scimusmn/nysci-combined-sewer/code/demo2/README.md

This folder contains three sketches, each used for the demonstration version of the Combined Sewer. `demo-controller` contains the code for the lighting controller; `demo-switches` contains the code for the user input controller; and `address-finder` is a helper sketch to blinnk the binary addresses fo each pixel.

The `camera-reader` python script is intended to make reading the addresses blinked by `address-finder` easier.
