scimusmn/nysci-combined-sewer/code/demo/address-query/README.md

# address-query

## usage

Upload the `address-query.ino` sketch to your Teensy and close all Arduino windows. Then, open this folder in `cmd.exe` and type

```
conda activate css-finder
python finder.py [YOUR_TEENSY_PORT_HERE]
```

## installation

tbd
