scimusmn/nysci-combined-sewer/electronics/LED Segment BOM.xlsx

Comment | Designator | Footprint | LCSC Part Number
Receivers 0/4 SOIC-16 RS-485 / RS-422 ICs ROHS | U2 | SMM:DS26C31TMX | C527395 (https://jlcpcb.com/partdetail/TexasInstruments-DS26C32ATMXNOPB/C527395)
2.2uF | C1 | Capacitor_SMD:C_0805_2012Metric
1uF | C2 | Capacitor_SMD:C_0805_2012Metric
120 Ohm Surface Mount Resistor | R1 | Resistor_SMD:R_1206_3216Metric | C880970 (https://jlcpcb.com/partdetail/Ever_OhmsTech-CR1206F120RP05Z/C880970)
120 Ohm Surface Mount Resistor | R2 | Resistor_SMD:R_1206_3216Metric | C880970 (https://jlcpcb.com/partdetail/Ever_OhmsTech-CR1206F120RP05Z/C880970)
SOIC8(S) RS-485 / RS-422 ICs ROHS | U1 | Package_SO:SOIC-8_3.9x4.9mm_P1.27mm | C130186 (https://jlcpcb.com/partdetail/Chipanalog-CAIF4850HS/C7422579)
100mA Fixed 5V~5V Positive 30V TO-252-2(DPAK) Linear Voltage Regulators (LDO) ROHS | U3 | Package_TO_SOT_SMD:TO-252-2 | C179571 (https://jlcpcb.com/partdetail/Onsemi-LP2950CDT_50RKG/C179571)
