scimusmn/nysci-combined-sewer/electronics/led_segment/production/led_segment-gerber/LED Segment BOM.xlsx

Comment | Designator | Footprint | LCSC Part Number
Receivers 0/4 SOIC-16 RS-485 / RS-422 ICs ROHS | U2 | SMM:DS26C31TMX | C527395 (https://jlcpcb.com/partdetail/TexasInstruments-DS26C32ATMXNOPB/C527395)
3.3uF | C1 | Capacitor_SMD:C_0805_2012Metric
1uF | C2 | Capacitor_SMD:C_0805_2012Metric
200uF | C3 | Capacitor_Tantalum_SMD:CP_EIA-7361-38_AVX-V
120 Ohm Surface Mount Resistor | R1 | Resistor_SMD:R_1206_3216Metric | C880970 (https://jlcpcb.com/partdetail/Ever_OhmsTech-CR1206F120RP05Z/C880970)
120 Ohm Surface Mount Resistor | R2 | Resistor_SMD:R_1206_3216Metric | C880970 (https://jlcpcb.com/partdetail/Ever_OhmsTech-CR1206F120RP05Z/C880970)
SOIC8(S) RS-485 / RS-422 ICs ROHS | U1 | Package_SO:SOIC-8_3.9x4.9mm_P1.27mm | C130186 (https://jlcpcb.com/partdetail/Chipanalog-CAIF4850HS/C7422579)
500mA Fixed 5V Positive electrode 35V TO-252-2L Voltage Regulators - Linear, Low Drop Out (LDO) Regulators ROHS | U3 | Package_TO_SOT_SMD:TO-252-2 | C9070
