scimusmn/nysci-combined-sewer/electronics/led_segment/led_segment.kicad_pcb

## KiCad design electronics/led_segment/led_segment.kicad_pcb (2024-12-06)

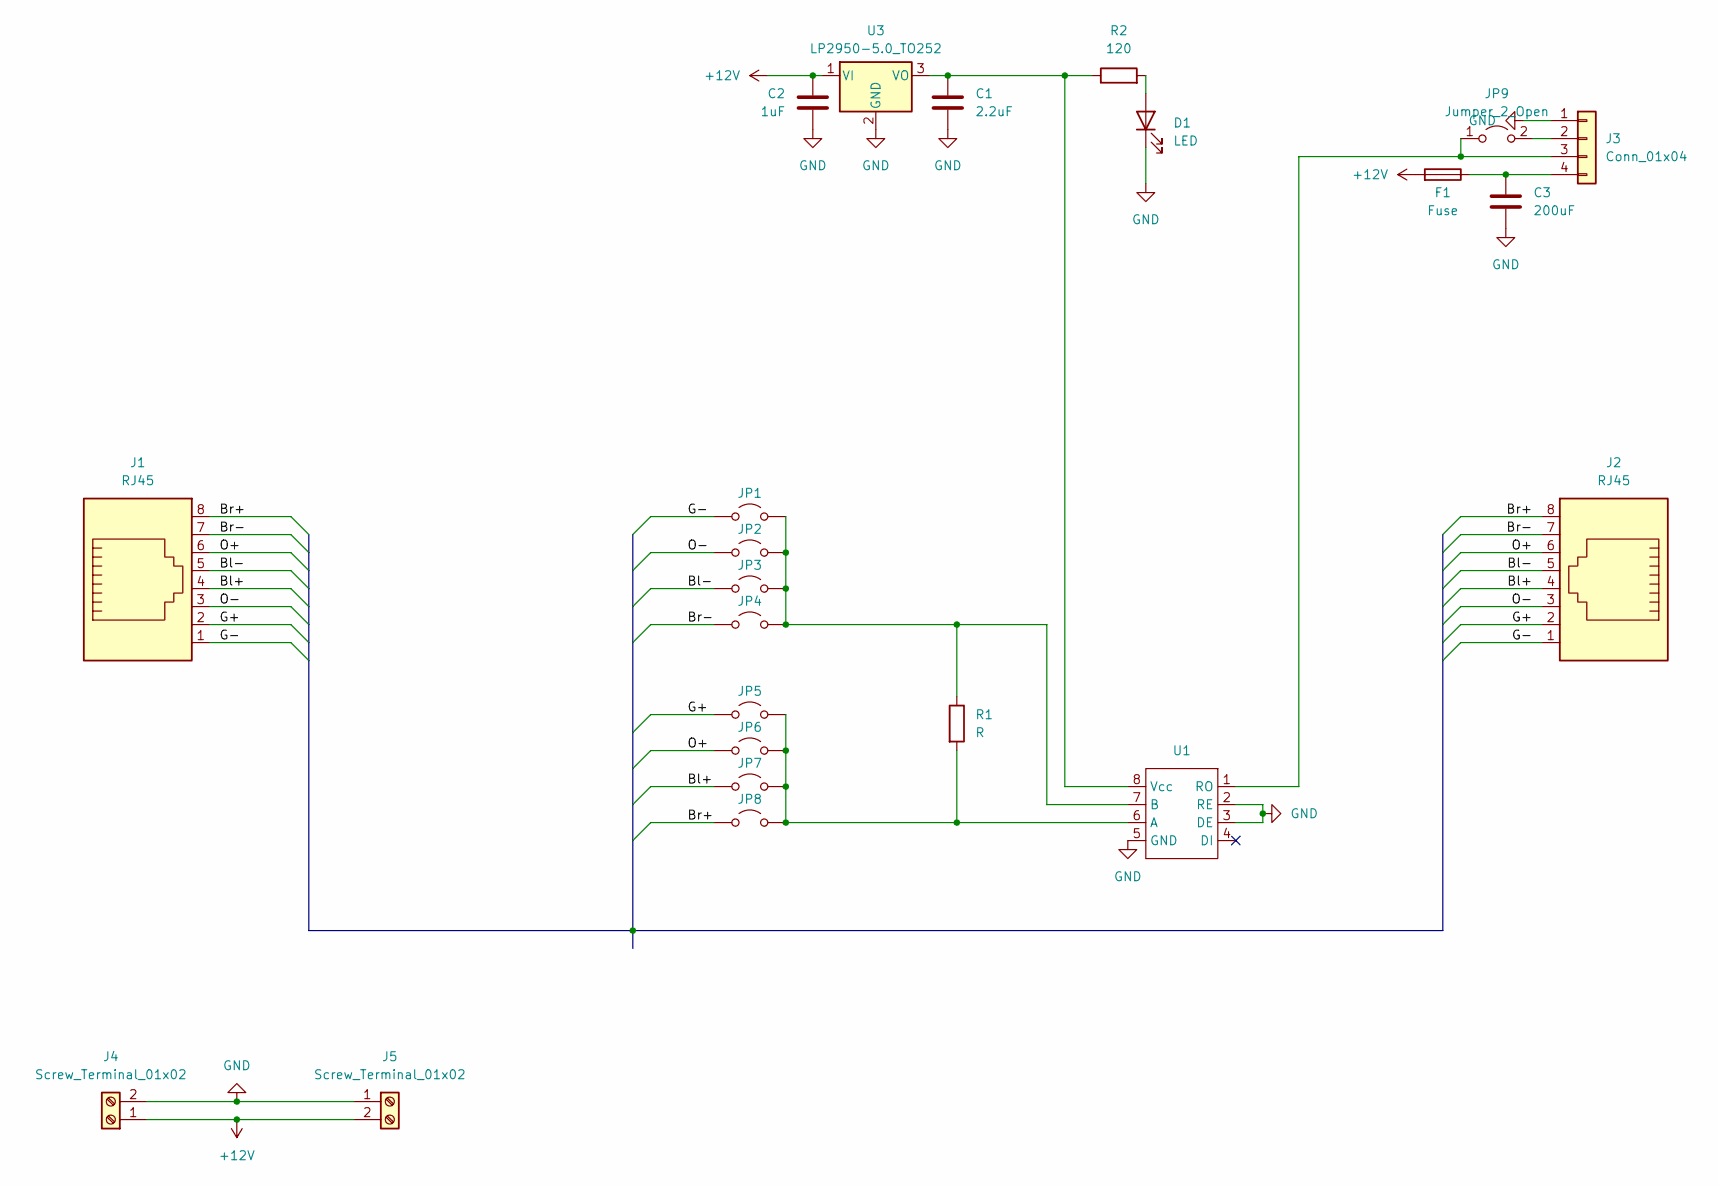
[picture p1: schematic led_segment.kicad_sch]

Parts:
C1: 2.2uF; C_0805_2012Metric; LCSC C377773
C2: 1uF; C_0805_2012Metric; LCSC C28323
C3: 200uF; CP_EIA-7361-38_AVX-V; LCSC TAJV227M016RNJ
D1: LED; LED_D3.0mm
F1: Fuse; 3549-2
J1, J2: RJ45; RJ45_Ninigi_GE; LCSC C708636
J3: Conn_01x04; KK-1x04_right
J4, J5: Screw_Terminal_01x02; P-2604-1102_1
JP1, JP2, JP3, JP4, JP5, JP6, JP7, JP8, JP9: Jumper_2_Open; SolderJumper-2_P1.3mm_Open_Pad1.0x1.5mm
R1: R; R_1206_3216Metric
R2: 120; R_1206_3216Metric
U1: SOIC-8_3.9x4.9mm_P1.27mm; LCSC C7422579
U3: LP2950-5.0_TO252; TO-252-2; LCSC C130186

Connections:
+12V: C2.1, F1.2, J4.1, J5.2, U3.1 (VI)
/Bl+: J1.4, J2.4, JP7.1 (A)
/Bl-: J1.5, J2.5, JP3.1 (A)
/Br+: J1.8, J2.8, JP8.1 (A)
/Br-: J1.7, J2.7, JP4.1 (A)
/G+: J1.2, J2.2, JP5.1 (A)
/G-: J1.1, J2.1, JP1.1 (A)
/O+: J1.6, J2.6, JP6.1 (A)
/O-: J1.3, J2.3, JP2.1 (A)
GND: C1.2, C2.2, C3.2, D1.1 (K), J3.1, J4.2, J5.1, U1.2 (RE), U1.3 (DE), U1.5 (GND), U3.2 (GND)
unnamed: D1.2 (A), R2.2
unnamed: J3.2, JP9.2 (B)
unnamed: J3.3, JP9.1 (A), U1.1 (RO)
unnamed: C3.1, F1.1, J3.4
unnamed: JP1.2 (B), JP2.2 (B), JP3.2 (B), JP4.2 (B), R1.1, U1.7 (B)
unnamed: JP5.2 (B), JP6.2 (B), JP7.2 (B), JP8.2 (B), R1.2, U1.6 (A)
unnamed: C1.1, R2.1, U1.8 (Vcc), U3.3 (VO)

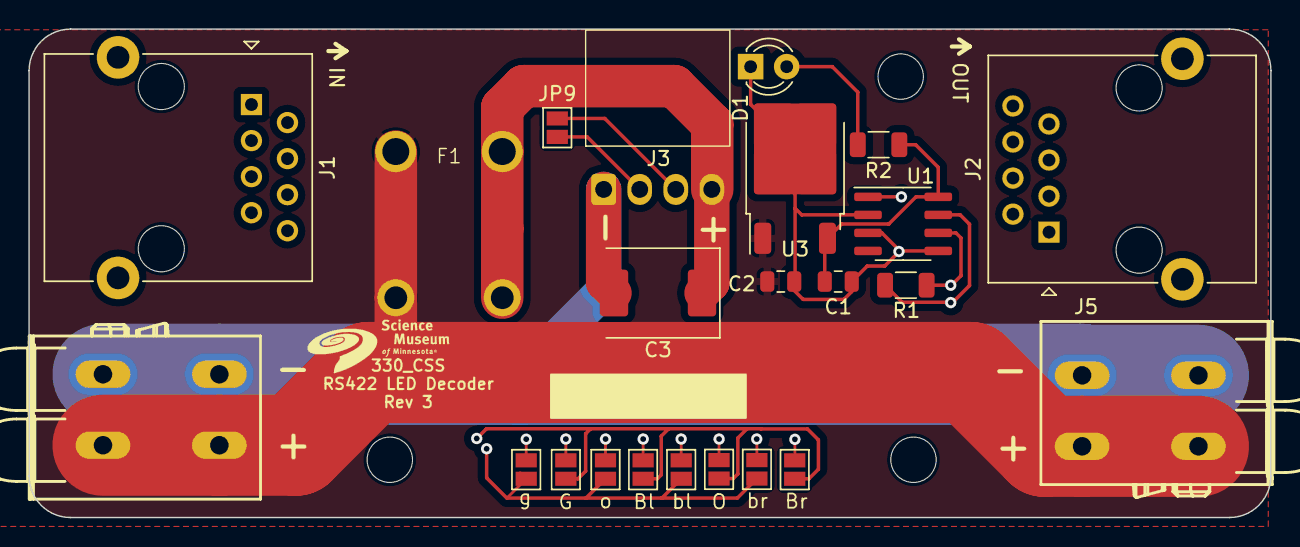
[picture p2: board led_segment.kicad_pcb from above]

Board: 4 copper layers, 87.5 x 34.4 mm, 23 parts (0 on the bottom side), 17 nets.
