scimusmn/nysci-combined-sewer/code/demo2/demo-switches/demo-switches.ino

#define SMM_IMPLEMENTATION
#include "smm.h"
#include "messages.h"
#include "rain.h"
#include "timeout.h"

#define LEVEL_TIMEOUT 3000

#define RAIN_ONE_SFX_PIN 6
#define RAIN_TWO_SFX_PIN 7
#define RAIN_THREE_SFX_PIN 8


#define TOILET_PIN 17
#define RAIN_PIN 16

#define WASHER_PIN 14
#define DISHWASHER_PIN 18
#define SHOWER_PIN 15


InputLevels levels = {
  0, 0, 0, 0, 0,
};

class LevelSwitch : public smm::Switch {
  public:
  LevelSwitch(int pin, uint8_t *level) 
  : smm::Switch(pin), level(level)
  {}
  void onLow() {
    active = true;
    *level = min(max(*level+1,holdLevel+1), 3);
    holdLevel = *level;
    updateFlag = true;
    if (time == 0) {
      time = millis() + LEVEL_TIMEOUT;
    }
  }
  void onHigh() {
    if(active){
      hold = millis() + 150;
      open = millis() + 200;
    }
    active = false;
    // *level = 0;
    // //if(holdLevel == 3){holdLevel = 0;}
    // updateFlag = true;
    // // if (millis() > time) {
    // //   updateFlag = true;
    // //   time = 0;
    // // }
  }
  void update() {
    if (!active && time != 0 && millis() > time && open < millis() && open != 0) {
      holdLevel = 0;
      *level = 0;
      open = 0;
      updateFlag = true;
      time = 0;
    }
    else if(!active && hold != 0 && millis() > hold){
      *level = 0;
      hold = 0;
      updateFlag = true;
    }
  }
  static volatile bool updateFlag;
  uint8_t holdLevel;

  private:
  uint8_t *level;
  bool active = false;
  unsigned long time = 0;
  unsigned long hold = 0;
  unsigned long open = 0;
};
volatile bool LevelSwitch::updateFlag = false;

LevelSwitch rainSwitch(RAIN_PIN, &(levels.rainFlow));
LevelSwitch toiletSwitch(TOILET_PIN, &(levels.toiletFlow));
LevelSwitch washerSwitch(WASHER_PIN, &(levels.washerFlow));
LevelSwitch dishSwitch(DISHWASHER_PIN, &(levels.dishWasherFlow));
LevelSwitch showerSwitch(SHOWER_PIN, &(levels.showerFlow));

void updateSwitches() {
  rainSwitch.update();
  toiletSwitch.update();
  washerSwitch.update();
  dishSwitch.update();
  showerSwitch.update();
}


void processInputLevels(uint8_t src, InputLevels levels) {}
void processPipeOutput(uint8_t src, CanPipeOutput output) {}
void processPipeOverflow(uint8_t src, CanPipeOverflow o) {}

void updateAudio(uint8_t Levels){
  if(Levels == 1){digitalWrite(RAIN_ONE_SFX_PIN,HIGH);Serial.println("light rain");}
  else if (Levels == 2){digitalWrite(RAIN_TWO_SFX_PIN,HIGH);delay(10);digitalWrite(RAIN_ONE_SFX_PIN,LOW);Serial.println("medium rain");}
  else if (Levels == 3){digitalWrite(RAIN_THREE_SFX_PIN,HIGH);delay(10);digitalWrite(RAIN_TWO_SFX_PIN,LOW);Serial.println("Heavy rain");}
  else{
    digitalWrite(RAIN_ONE_SFX_PIN,LOW);
    digitalWrite(RAIN_TWO_SFX_PIN,LOW);
    digitalWrite(RAIN_THREE_SFX_PIN,LOW);
  }
}


Timeout overflowClock;
#define OVERFLOW_CLOCK_INTERVAL 500
void overflowClockFn(void*) {
  static bool swap = false;
  sendCanSwapColors(swap);
  swap = !swap;
  overflowClock.set(OVERFLOW_CLOCK_INTERVAL, overflowClockFn);
}


void setup() {
  Serial.begin(9600);
  delay(1000);
  setupCan(0);
  Serial.println("[switches] boot!");
  smm::setup();
  setupRain();
  overflowClock.set(OVERFLOW_CLOCK_INTERVAL, overflowClockFn);

  pinMode(RAIN_ONE_SFX_PIN,OUTPUT);
  pinMode(RAIN_TWO_SFX_PIN,OUTPUT);
  pinMode(RAIN_THREE_SFX_PIN,OUTPUT);
}

void loop() {
  overflowClock.update();
  updateRain(rainSwitch.holdLevel);
  updateAudio(rainSwitch.holdLevel);
  updateSwitches();
  // Serial.println("[switches] update!");
  if (LevelSwitch::updateFlag) {
    LevelSwitch::updateFlag = false;
    sendCanBusInputLevels(levels);
    Serial.println("================================================================");
    Serial.print("rain: "); Serial.println(rainSwitch.holdLevel);
    Serial.print("toilet: "); Serial.println(levels.toiletFlow);
    Serial.print("washer: "); Serial.println(levels.washerFlow);
    Serial.print("dishwasher: "); Serial.println(levels.dishWasherFlow);
    Serial.print("shower: "); Serial.println(levels.showerFlow);
    Serial.println("\n");
  }
}
