scimusmn/nysci-combined-sewer/code/demo2/demo2-icons-cl/demo2-icons-cl.ino

#include <OctoWS2811.h>
#include "messages.h"

InputLevels levels;
//InputLevels nextLevels = { 1, 1, 1, 1, 1 };
InputLevels nextLevels = { 0, 0, 0, 0, 0};
bool updatedLevels = true;


void processInputLevels(uint8_t src, InputLevels levels) {
  //Serial.println("new levels!");
  memcpy(&nextLevels, &levels, sizeof(InputLevels));
  updatedLevels = true;
}



int invert(int x) {
  return x == 1 ? 0 : 1;
}

void tryUpdateLevels() {
  static unsigned long time = 1000;
  static unsigned int index = 0;
  if (millis() > time) {
    updatedLevels = true;
    time = millis() + 1000 + (rand() % 4000);
    switch (index) {
      case 0:
        nextLevels.toiletFlow = invert(nextLevels.toiletFlow);
        break;
      case 1:
        nextLevels.showerFlow = invert(nextLevels.showerFlow);
        break;
      case 2:
        nextLevels.dishWasherFlow = invert(nextLevels.dishWasherFlow);
        break;
      case 3:
        nextLevels.washerFlow = invert(nextLevels.washerFlow);
        break;
      default:
        break;
    };
    index = rand() % 4;
  }
}




// the leds
typedef OctoWS2811 LedStrip_t;
#define LEDS_PER_STRIP 420
#define NUM_PINS 8
uint8_t ledPins[] = { 2, 3, 4, 5, 6, 7, 8, 9 };
DMAMEM int displayMemory[LEDS_PER_STRIP * NUM_PINS * 3 / 4];
LedStrip_t strip(LEDS_PER_STRIP, displayMemory, nullptr, WS2811_RGB | WS2811_800kHz, NUM_PINS, ledPins);


class Icon;

struct IconList {
  Icon *icon = nullptr;
  IconList *next = nullptr;
  void setLevel(unsigned int level);
  unsigned int timeout = 0;
  unsigned int level = 0;
  bool on;
  void update(unsigned int level) {
    if(level > 0 && this->level == 0){
      timeout = millis()+3000;
      setLevel(level);
    }
    else if(level > this->level){setLevel(level);}
    else if (level == 0 && this->level != level && millis() > timeout){setLevel(level);}
    // if (level == 0 && this->level > 0) {
    //   if (millis() > timeout) {
    //     setLevel(level);
    //   }
    // } else if (level != this->level) {
    //   if (level == 0) {
    //     timeout = millis() + 3000;
    //   }
    //   setLevel(level);
    // }
  }
};

// icon class
// #define ICON_COLOR 0xff, 0xff, 0xff
#define ICON_COLOR 0xffffff
class Icon {
  public:
  unsigned int level;

  Icon(size_t begin, size_t end, int Level, IconList *list=nullptr) 
    : begin(begin), end(end) {
    if (list != nullptr) {
      IconList *self = new IconList;
      self->icon = this;
      self->next = list->next;
      list->next = self;
      level = Level;
      Serial.println((unsigned int) list->next->icon, HEX);
      Serial.println((unsigned int) this, HEX);
    }
  }
  void show() {
    for (int i=begin; i<end; i++) {
      strip.setPixel(i, ICON_COLOR);
    }
  }
  void hide() {
    for (int i=begin; i<end; i++) {
      strip.setPixel(i, 0);
    }
  }

  // protected:
  size_t begin, end;
};

void IconList::setLevel(unsigned int level) {
  this->level = level;
  for (IconList *it = next; it != nullptr; it = it->next) {
    Icon *icon = it->icon;
    if (level > 0) {
      if(icon->level <= level){icon->show();}
      Serial.print("show "); Serial.print(icon->begin); Serial.print(", "); Serial.println(icon->end);
    } else {
      icon->hide();
    }
  }
}


IconList *toilet = new IconList;
IconList *shower = new IconList;
IconList *washer = new IconList;
IconList *dishwasher = new IconList;


void setupIcons();
void updateIconList(IconList *list, int level);
int levelMap(int level, int count);
void updateIcons();




void setupIcons() {
  toilet->next = nullptr;
  shower->next = nullptr;
  washer->next = nullptr;
  dishwasher->next = nullptr;
  // cl
  Icon *cl0 = new Icon(0, 60, 1, toilet);
  Icon *cl1 = new Icon(61, 120, 3, shower);
  Icon *cl2 = new Icon(420, 480, 2, shower);
  Icon *cl3 = new Icon(480, 540, 2,toilet);
  Icon *cl4 = new Icon(121, 180, 3,toilet);
  Icon *cl5 = new Icon(180, 240, 1,shower);
  Icon *cl6 = new Icon(540, 600, 3,dishwasher);
  Icon *cl7 = new Icon(600, 659, 1,washer);
  Icon *cl8 = new Icon(240, 300, 2,dishwasher);
  Icon *cl9 = new Icon(600, 719, 3,washer);
  Icon *cl10 = new Icon(719, 779, 3,shower);
  Icon *cl11 = new Icon(779, 840, 1,toilet);
  Icon *cl12 = new Icon(840, 900, 2,toilet);
  Icon *cl13 = new Icon(300, 360, 3,shower);
  Icon *cl14 = new Icon(360, 420, 3,washer);
  Icon *cl15 = new Icon(1260, 1320, 1,dishwasher);
  Icon *cl16 = new Icon(900, 960, 2,shower);
  Icon *cl17 = new Icon(960, 1020, 3,toilet);
  Icon *cl18 = new Icon(1320, 1380, 3,washer);
  Icon *cl19 = new Icon(1380, 1440, 3,dishwasher);
  Icon *cl20 = new Icon(1020, 1080, 1,washer);
  Icon *cl21 = new Icon(1080, 1140, 2,washer);
  Icon *cl22 = new Icon(1140, 1200, 1,washer);
  Icon *cl23 = new Icon(1440, 1500, 3,washer);
  Icon *cl24 = new Icon(1500, 1560, 1,washer);
}


int levelMap(int level, int count) {
  if (level) {
    return count;
  } else {
    return 0;
  }
  /*if (level == 2) {
    return min(2, count);
  } else if (level == 3) {
    return count;
  } else {
    return level;
  }*/
}

void updateIcons() {
  toilet->update(levels.toiletFlow);
  washer->update(levels.washerFlow);
  dishwasher->update(levels.dishWasherFlow);
  shower->update(levels.showerFlow);
  strip.show();
}



// main setup/loop
void setup() {
  srand(0);
  Serial.begin(9600);
  delay(1000);
  Serial.println("[icons] boot!");
  setupIcons();
  setupCan();
  strip.begin();
  Serial.println("setup complete");
  // updateIcons();
}


void loop() {
  // Serial.println("toilet");
  // updateIconList(toilet, 1);
  // strip.show();
  // delay(1000);
  // updateIconList(toilet, 0);
  // Serial.println("shower");
  // updateIconList(shower, 1);
  // strip.show();
  // delay(1000);
  // updateIconList(shower, 0);
  // Serial.println("washer");
  // updateIconList(washer, 1);
  // strip.show();
  // delay(1000);
  // updateIconList(washer, 0);
  // Serial.println("dishwasher");
  // updateIconList(dishwasher, 1);
  // strip.show();
  // delay(1000);
  // updateIconList(dishwasher, 0);
  //tryUpdateLevels();
  updateIcons();
  if (updatedLevels) {
    Serial.println("UPDATED LEVELS");
    updatedLevels = false; // reset flag
    memcpy(&levels, &nextLevels, sizeof(InputLevels)); // copy levels
  }
}
