scimusmn/nysci-combined-sewer/code/demo2/address-finder/address-finder.ino

/*  OctoWS2811 BasicTest.ino - Basic RGB LED Test
    http://www.pjrc.com/teensy/td_libs_OctoWS2811.html
    Copyright (c) 2013 Paul Stoffregen, PJRC.COM, LLC

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
  Required Connections
  --------------------
    pin 2:  LED Strip #1    OctoWS2811 drives 8 LED Strips.
    pin 14: LED strip #2    All 8 are the same length.
    pin 7:  LED strip #3
    pin 8:  LED strip #4    A 100 ohm resistor should used
    pin 6:  LED strip #5    between each Teensy pin and the
    pin 20: LED strip #6    wire to the LED strip, to minimize
    pin 21: LED strip #7    high frequency ringining & noise.
    pin 5:  LED strip #8
    pin 15 & 16 - Connect together, but do not use
    pin 4 - Do not use
    pin 3 - Do not use as PWM.  Normal use is ok.

  This test is useful for checking if your LED strips work, and which
  color config (WS2811_RGB, WS2811_GRB, etc) they require.
*/

#include <OctoWS2811.h>

const int ledsPerStrip = 300;

DMAMEM int displayMemory[ledsPerStrip*6];
int drawingMemory[ledsPerStrip*6];

const int config = WS2811_GRB | WS2811_800kHz;

OctoWS2811 leds(ledsPerStrip, displayMemory, drawingMemory, config);

void setup() {
  leds.begin();
  blank();
}

#define RED    0xFF0000
#define GREEN  0x00FF00
#define BLUE   0x0000FF
#define YELLOW 0xFFFF00
#define PINK   0xFF1088
#define ORANGE 0xE05800
#define WHITE  0xFFFFFF

// Less intense...
/*
#define RED    0x160000
#define GREEN  0x001600
#define BLUE   0x000016
#define YELLOW 0x101400
#define PINK   0x120009
#define ORANGE 0x100400
#define WHITE  0x101010
*/

void loop() {
  #define SHOW_TIME 990
  #define BLANK_TIME 10
  delay(SHOW_TIME);
  for (int i=0; i<11; i++) {
    showBit(i); delay(SHOW_TIME); blank(); delay(BLANK_TIME);
  }
}

void colorWipe(int color, int wait)
{
  for (int i=0; i < leds.numPixels(); i++) {
    leds.setPixel(i, color);
    leds.show();
    delayMicroseconds(wait);
  }
}


void blank() {
  for (int i=0; i<leds.numPixels(); i++) {
    leds.setPixel(i, 0);
  }
  leds.show();
}

void showBit(int n) {
  for (int i=0; i<leds.numPixels(); i++) {
    if (i & (1 << n)) {
      leds.setPixel(i, 0x160000);
    } else {
      leds.setPixel(i, 0);
    }
  }
  leds.show();
}
