scimusmn/nysci-combined-sewer/code/demo2/demo2-controller-cl/pipes.cpp

#include "flow.h"


#define SEGMENT0 1168, 1208 //
#define SEGMENT10 1160, 1168 //
#define SEGMENT20 1208, 1231 //
#define SEGMENT30 1302, 1353 //
#define SEGMENT40 8, 49 //
#define SEGMENT50 0, 8 //
#define SEGMENT60 50, 72 //
#define SEGMENT70 142, 193 //
#define SEGMENT80 1239, 1280 //
#define SEGMENT90 1231, 1239 //
#define SEGMENT100 1280, 1302 //

#define SEGMENT110 1353, 1435 //
#define SEGMENT120 80, 120 //
#define SEGMENT130 72, 80 //
#define SEGMENT140 120, 142 //
#define SEGMENT150 193, 222 //
#define SEGMENT160 290, 344 //
#define SEGMENT170 1458, 1499 //
#define SEGMENT180 1450, 1458 //
#define SEGMENT190 1499, 1520 //
#define SEGMENT200 1520, 1553

#define SEGMENT210 1552, 1594
#define SEGMENT220 222, 259
#define SEGMENT230 344, 395
#define SEGMENT240 1594, 1658
#define SEGMENT250 1658, 1691

#define SEGMENT260 1691, 1720
#define SEGMENT265 1742, 1792

#define SEGMENT270 440, 480
#define SEGMENT280 432, 440
#define SEGMENT290 480, 504
#define SEGMENT300 396, 432

#define SEGMENT310 580, 630
#define SEGMENT320 1871, 1912
#define SEGMENT330 1863, 1871
#define SEGMENT340 1912, 1935
#define SEGMENT350 1792, 1863
#define SEGMENT360 512, 553
#define SEGMENT370 504, 512
#define SEGMENT380 553, 576
#define SEGMENT390 630, 706
#define SEGMENT400 1943, 1984

#define SEGMENT410 1935, 1943
#define SEGMENT420 1984, 2007
#define SEGMENT430 795, 829

#define SEGMENT440 829, 837
#define SEGMENT445 925, 974



#define SEGMENT450 731, 772
#define SEGMENT460 723, 731
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
    TPIPE(460, washers);
    PIPE(470);
    pipe470->attachInput(pipe450);
    pipe470->attachInput(pipe460);
    PIPE(480);
    pipe480->attachInput(pipe470);
    pipe480->attachInput(pipe390);
    PIPE(490);
    pipe480->attachInput(pipe480);
    PIPE(500);
    pipe500->attachInput(pipe490);

}
