scimusmn/nysci-combined-sewer/code/demo2/demo-switches/timeout.h

#pragma once


#define NUM_TIMEOUTS 8


typedef void (timefunc_t)(void*);


class Timeout {
  public:
  bool set(unsigned long ms, timefunc_t *f, void *data=nullptr);
  void clear();
  void update();

  private:
  unsigned long time = 0;
  timefunc_t *f = nullptr;
  void *data = nullptr;
};


class Timeouts {
  public:
  bool setTimeout(unsigned long ms, timefunc_t *f, void *data=nullptr);
  void update();
  private:
  Timeout timeouts[NUM_TIMEOUTS];
};
