scimusmn/nysci-combined-sewer/(commit log)

2024-08-13 re-implement jumpers
    [led_segment.kicad_pcb, led_segment.kicad_sch]
2024-08-14 consolidate self and input flows
2024-08-14 fix inserting NO_FLOW flows
    [demo-controller.ino, flow.cpp]
2024-08-15 get nice flow overlap
2024-08-16 add rain switch
2024-08-20 update graph & flow color length
2024-12-06 get peer review on rev.3 of boards
    [LED Segment BOM.xlsx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]
2024-12-10 confirm layout of updates
    [LED Segment BOM.xlsx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]
2025-01-08 add python camera script
2025-01-13 fix nullptr bug in flow.cpp
    [flow.cpp]
2025-01-13 use static memory for flows and input pipes
2025-01-13 remove superfluous debug printing
2025-01-14 Update pipes.cpp fl fixed one pixel too far
    [pipes.cpp]
2025-01-14 Update buttons to correct pins
    [switches.h]
2025-01-15 Bug fix FL(Building 1)
    [led_segment-top-pos.csv]
2025-01-18 fix switch interrupts
2025-01-21 implement constant flows
2025-01-21 update flow.*
2025-01-21 remove flowtype reference in demo2-controller-cl
2025-01-21 move pipe definition macros into flow.h
2025-01-21 remove flowtypes from startFlow calls
2025-01-22 flow changes
2025-01-22 do not track local changes to template files
2025-01-22 fix unbounded flow growth
    [flow.cpp]
2025-01-22 set initial flow values to zero
2025-01-28 fix 0-input draining bug
    [controller.cpp, flow.cpp]
2025-01-28 fix errors in timeout.*
    [timeout.cpp, timeout.h]
2025-01-28 add flow activation levels and fix can bus communication bug
    [controller.cpp, flow.cpp, flow.h, messages.cpp, messages.h]
2025-01-28 get pipe flows to match icon levels
2025-01-28 change default flow level to 1
2025-01-29 fine tune timing on buttons and icons
2025-01-29 implement flowcount-based poonami event
2025-01-31 make the switches control the color swap
    [controller-floor.ino, flow.cpp, messages.cpp, messages.h]
2025-01-31 darn those capitalization errors
    [controller-floor.ino]
2025-01-31 implement color swap message sending/processing
    [messages.cpp, messages.h]
2025-01-31 adjust switches code to send overflow color timeouts
